f18m/microirrigation-control/docs/9icxP.png

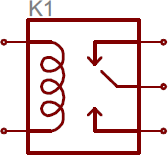
docs/9icxP.png
