f18m/microirrigation-control/software-lime2/spidev_test/README.txt

This utility was taken from Linux kernel tree:

 https://github.com/torvalds/linux/blob/master/tools/spi/spidev_test.c
