f18m/microirrigation-control/docs/BatteryMeasurements.ods

Sheet: Discharge_in_sleep_mode
Battery discharge trend for the remote node cyclying between the sleep mode and RX mode
Measurement date | Battery voltage
18/03/18 | 12,81
20/03/18 | 12,76
22/03/18 | 12,73
26/03/18 | 12,67
28/03/18 | 12,65
30/03/18 | 12,62
03/04/18 | 12,56
07/04/18 | 12,5
10/04/18 | 12,45
20/04/18 | 12,3
28/04/18 | 12,18
Difference between first and last measurements
41 | -0,63
Trend of discharge:
-0,015 | V/day
-0,015 | V/day
(standby conditions!)
 |  | Conv factor: | 0,069 | V/ADC
 |  | Offset: | 4,386 | V
Measurement date | ADC read | Battery Voltage (Estimated)
19/08/2018 | 116 | 12,43 | V
30/08/2018 | 102 | 11,46 | V
10/09/2018 | 94 | 10,90 | V
23/09/2018 | 74 | 9,52 | V
30/09/2018 | 55 | 8,20 | V
Difference between first and last measurements
42 | -61
Trend of discharge:
-1,452 | ADC counts/day
-0,101 | V/day
Measurement date | ADC read | Battery Voltage (Estimated)
04/11/2018 | 111 | 12,08 | V
Difference between first and last measurements
-43408 | -111
Trend of discharge:
0,003 | ADC counts/day
0,000 | V/day
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
