f18m/microirrigation-control/hardware-remote/remote_node_schematic.brd

## EAGLE design hardware-remote/remote_node_schematic.brd (2017-11-25, last stored version)

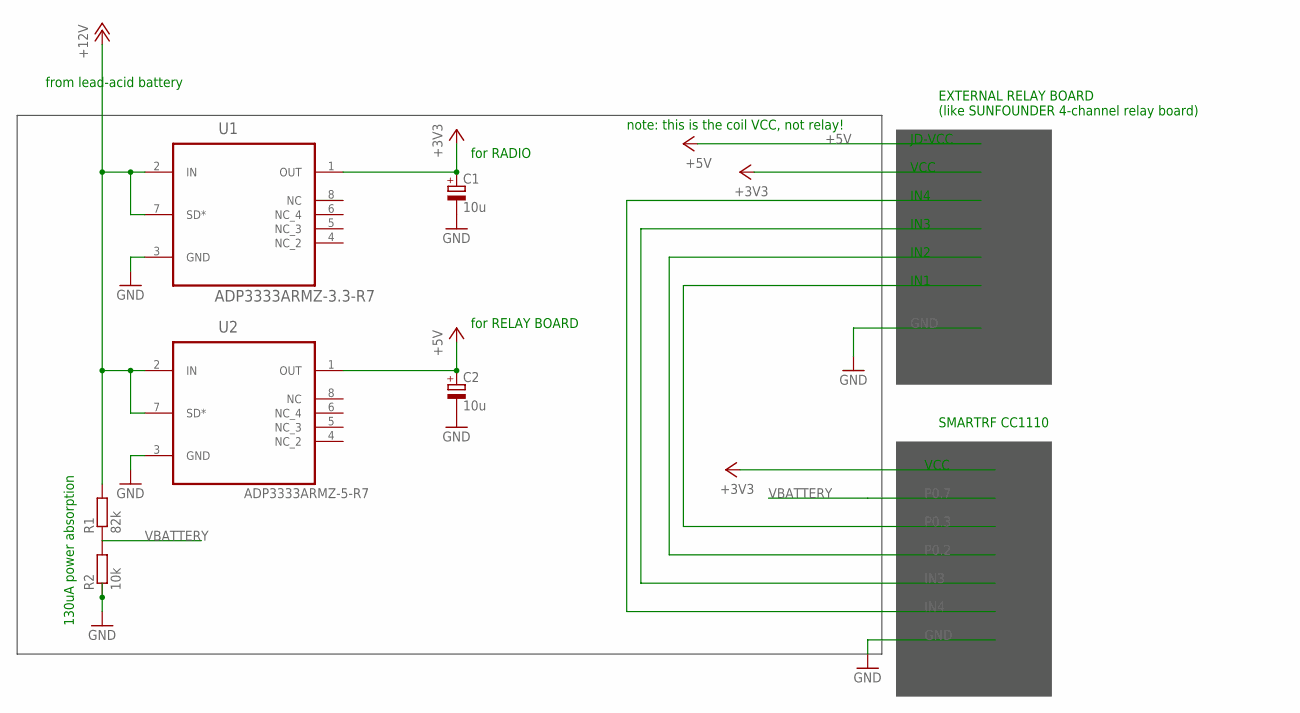
[picture p10: schematic remote_node_schematic.sch]

Parts:
C1, C2: 10u; 085CS_1AR
R1: 82k; 0207/10
R2: 10k; 0207/10
U1, U2: ADP3333ARMZ-3.3-R7; SOP65P490X110-8N

Connections:
+3V3: C1.+, U1.1 (OUT)
+9V: C2.+, U2.1 (OUT)
+12V: R1.2, U1.2 (IN), U1.7 (SD*), U2.2 (IN), U2.7 (SD*)
GND: C1.-, C2.-, R2.1, U1.3 (GND), U2.3 (GND)
VBATTERY: R1.1, R2.2

Notes on the sheet:
for RADIO
for RELAY BOARD
EXTERNAL RELAY BOARD (like SUNFOUNDER 4-channel relay board)
JD-VCC
VCC
from lead-acid battery
SMARTRF CC1110
note: this is the coil VCC, not relay!
IN2
IN1
130uA power absorption
IN4
IN3

Board: 2 copper layers, 6 parts (0 on the bottom side), 5 nets, no tracks yet.
