f18m/microirrigation-control/(commit log)

2017-10-16 First checkin of firmware
    LIME2 node: the SPI pretty much works
    REMOTE node: the radio system is pretty much working
2017-11-07 Get the project to usable state
    Too many fixes / developments to list
    [lime2.c, main.c, main.h, remote.c]
2017-11-13 create a PHP lib to handle SPI communication with radio
2017-11-25 add HW design docs
    [remote_node_schematic.brd, remote_node_schematic.sch]
2018-04-28 add battery measurements
    [BatteryMeasurements.ods]
2018-05-14 give battery read also from CLI utility
2018-08-17 add support to drive 2 relay channels independently
2018-08-18 more docs
    [BatteryMeasurements.ods]
2018-08-19 add wiring of SPI bus
2018-11-04 Update firmware with new NOOP command to get battery level
2018-11-04 update battery measurements
    [BatteryMeasurements.ods]
